kingdomallies/wro24-kingdomallies/WRO/t-photos/funnypic.jpeg

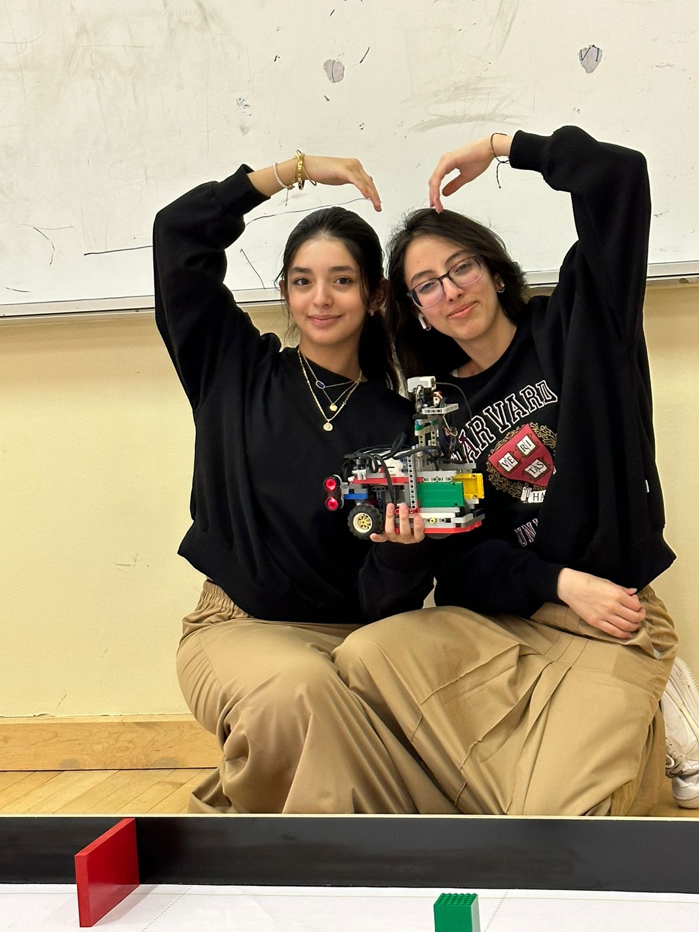
WRO/t-photos/funnypic.jpeg
