kingdomallies/wro24-kingdomallies/WRO/v-photos/v-right.jpg

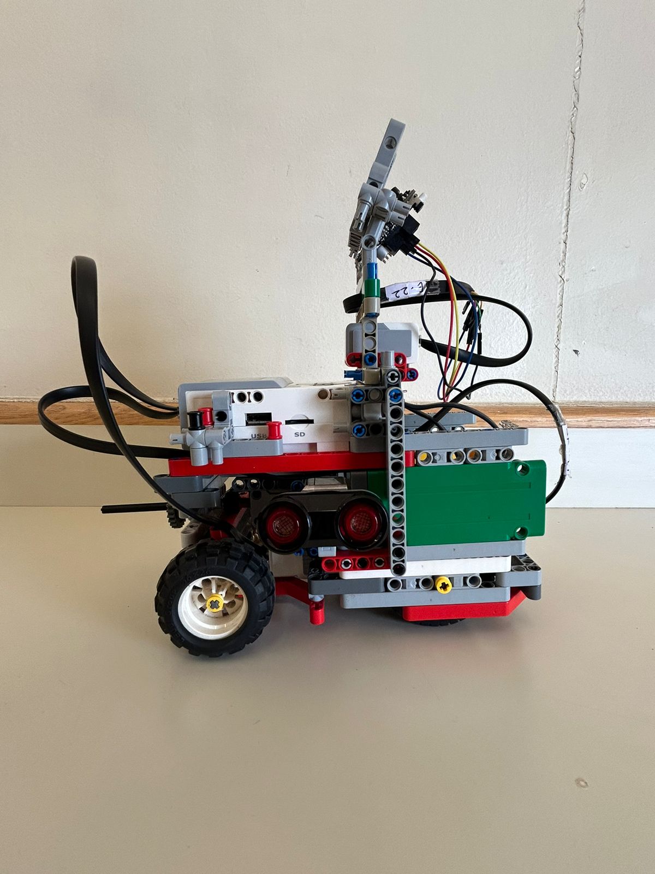
WRO/v-photos/v-right.jpg
