kingdomallies/wro24-kingdomallies/WRO/schemes/Robot Schematic.pdf

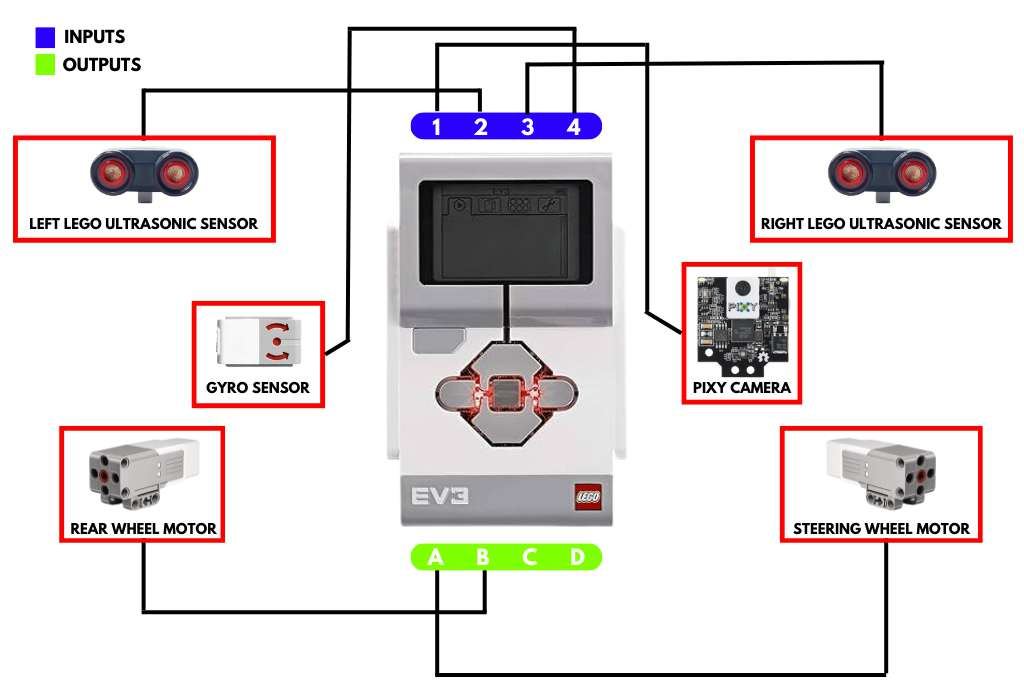
[picture p3: figure]
