kingdomallies/wro24-kingdomallies/WRO/t-photos/normalpic.jpeg

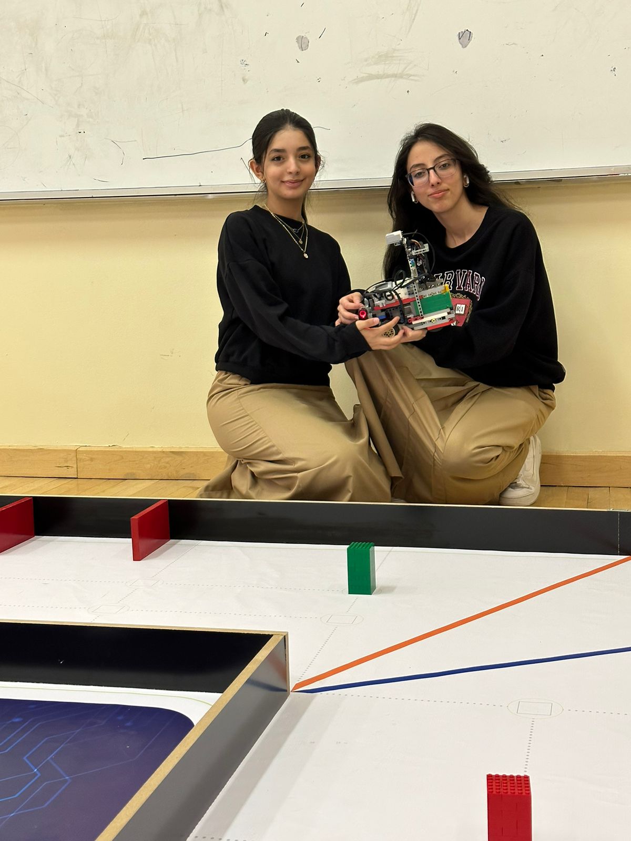
WRO/t-photos/normalpic.jpeg
