kingdomallies/wro24-kingdomallies/WRO/v-photos/v-back.jpg

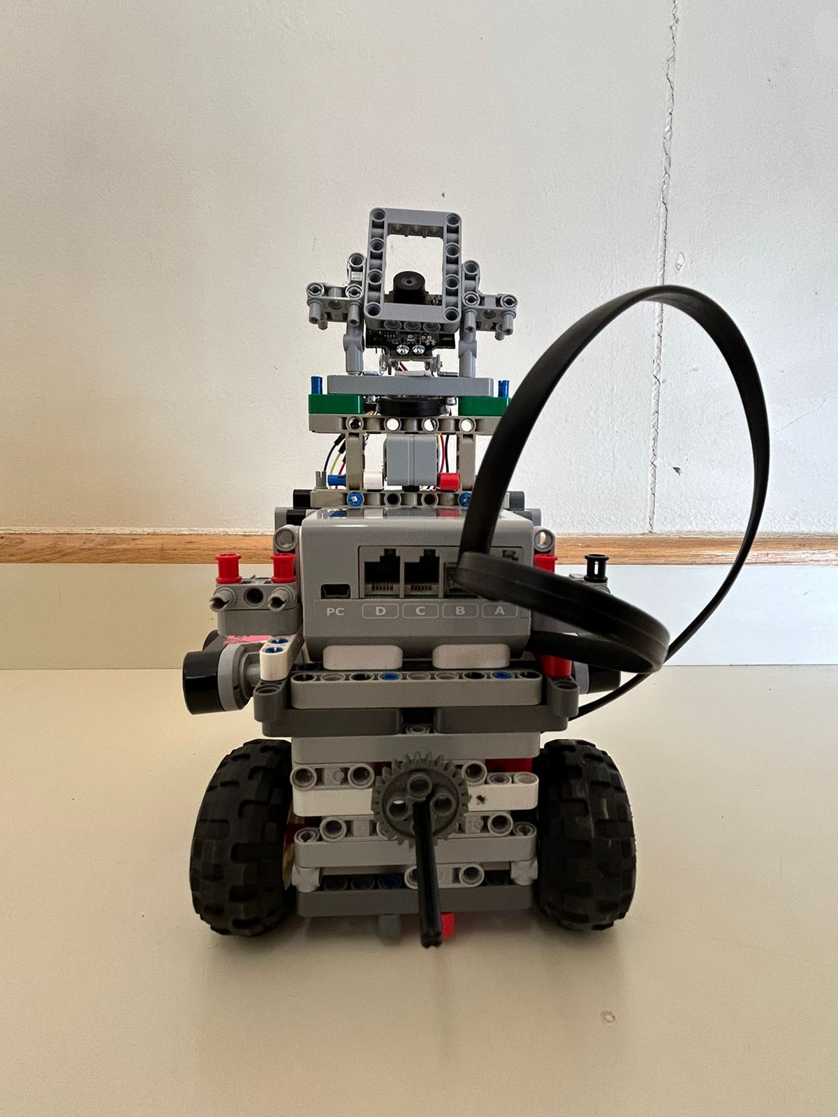
WRO/v-photos/v-back.jpg
