kingdomallies/wro24-kingdomallies/WRO/v-photos/v-bottom.jpg

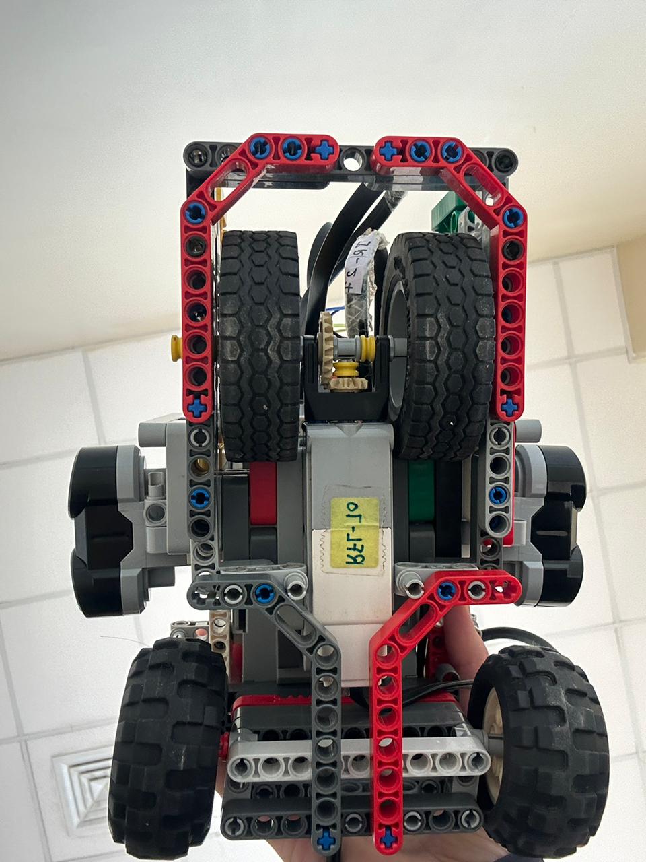
WRO/v-photos/v-bottom.jpg
