kingdomallies/wro24-kingdomallies/WRO/v-photos/v-front.jpg

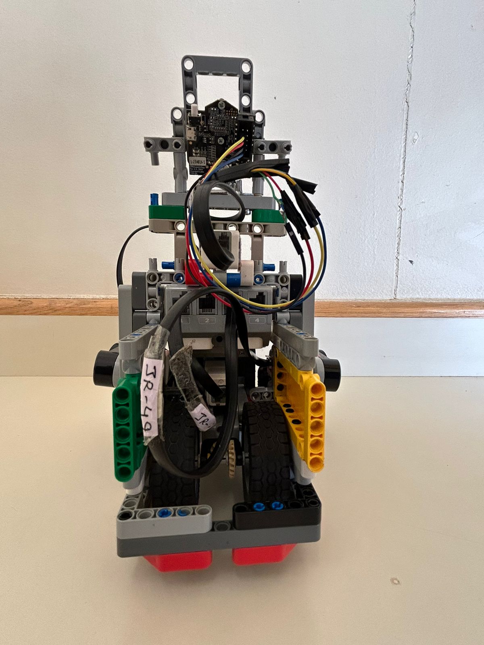
WRO/v-photos/v-front.jpg
