kingdomallies/wro24-kingdomallies/WRO/v-photos/v-left.jpg

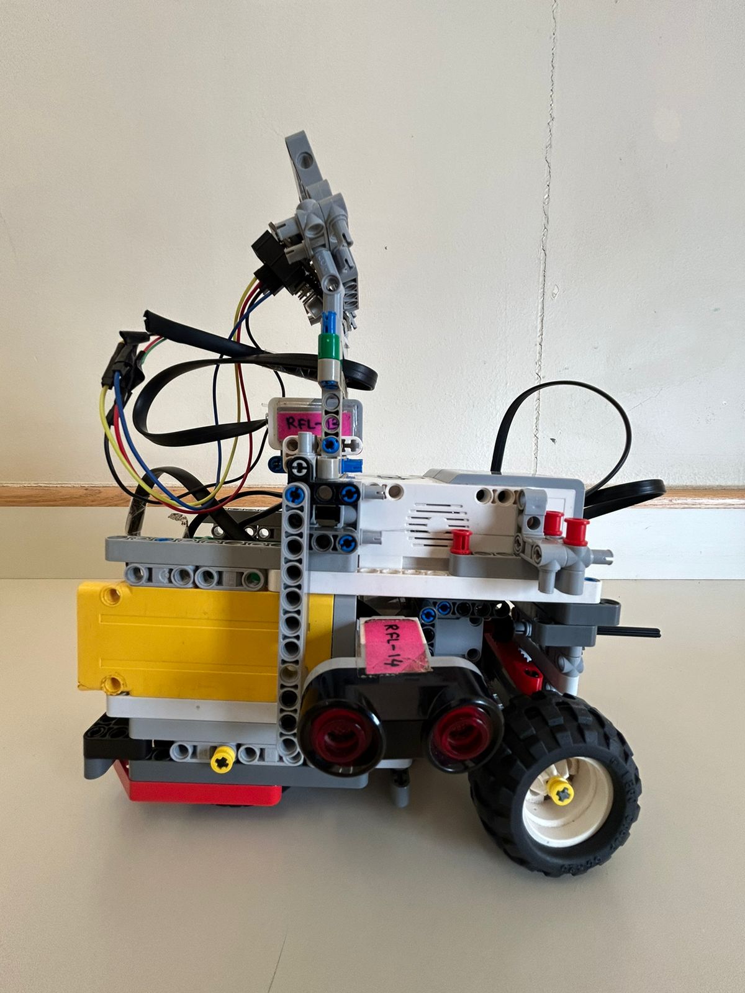
WRO/v-photos/v-left.jpg
