kingdomallies/wro24-kingdomallies/WRO/v-photos/v-top.jpg

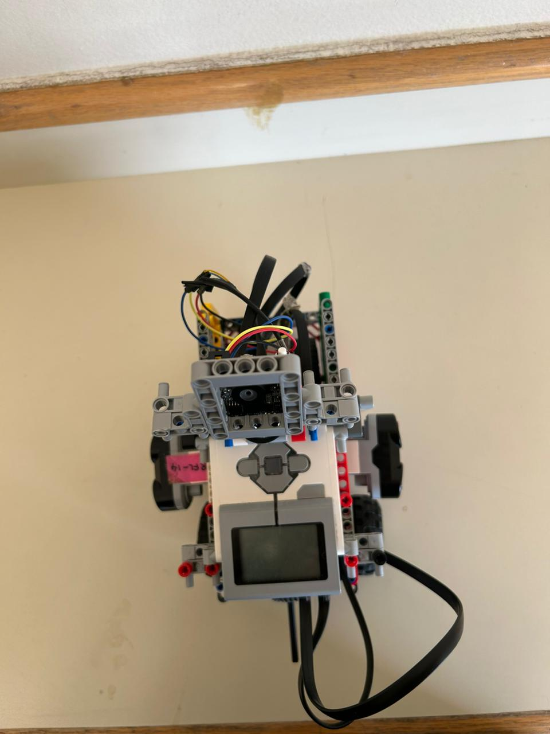
WRO/v-photos/v-top.jpg
