kingdomallies/wro24-kingdomallies/WRO/models/CAD 2NS GEAR MODEL.stl

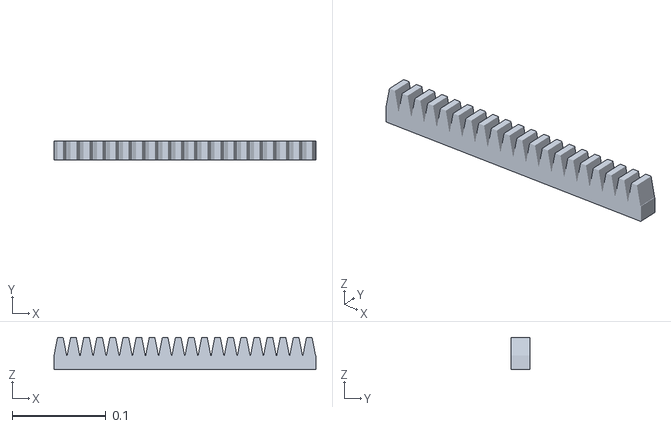
[picture p10: CAD file, 2024-09-28]
WRO/models/CAD 2NS GEAR MODEL.stl
0.28 x 0.02 x 0.0346
