kingdomallies/wro24-kingdomallies/WRO/models/CAD GEAR MODEL.stl

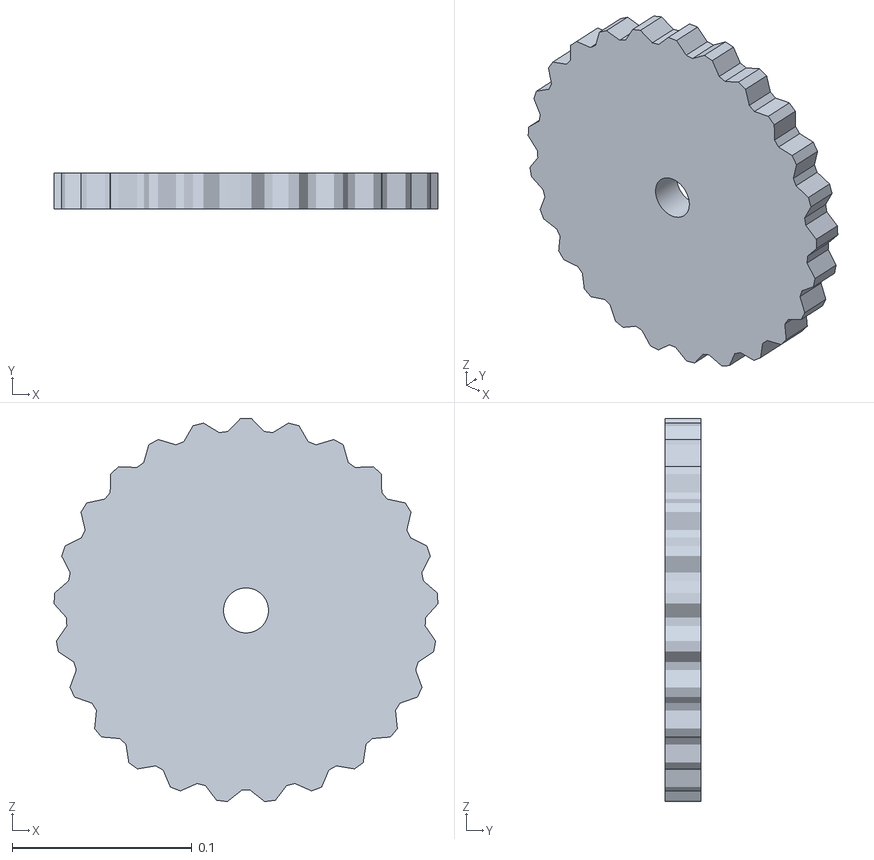
[picture p11: CAD file, 2024-09-28]
WRO/models/CAD GEAR MODEL.stl
0.214 x 0.02 x 0.213
